Pelleplutt/arduino-watercontrol/README.md

arduino-watercontrol
====================

An Arduino based humidity sensor and water control system
