Pelleplutt/arduino-watercontrol/schematics/display_buttons.sch

## EAGLE design schematics/display_buttons.sch (2013-06-27)

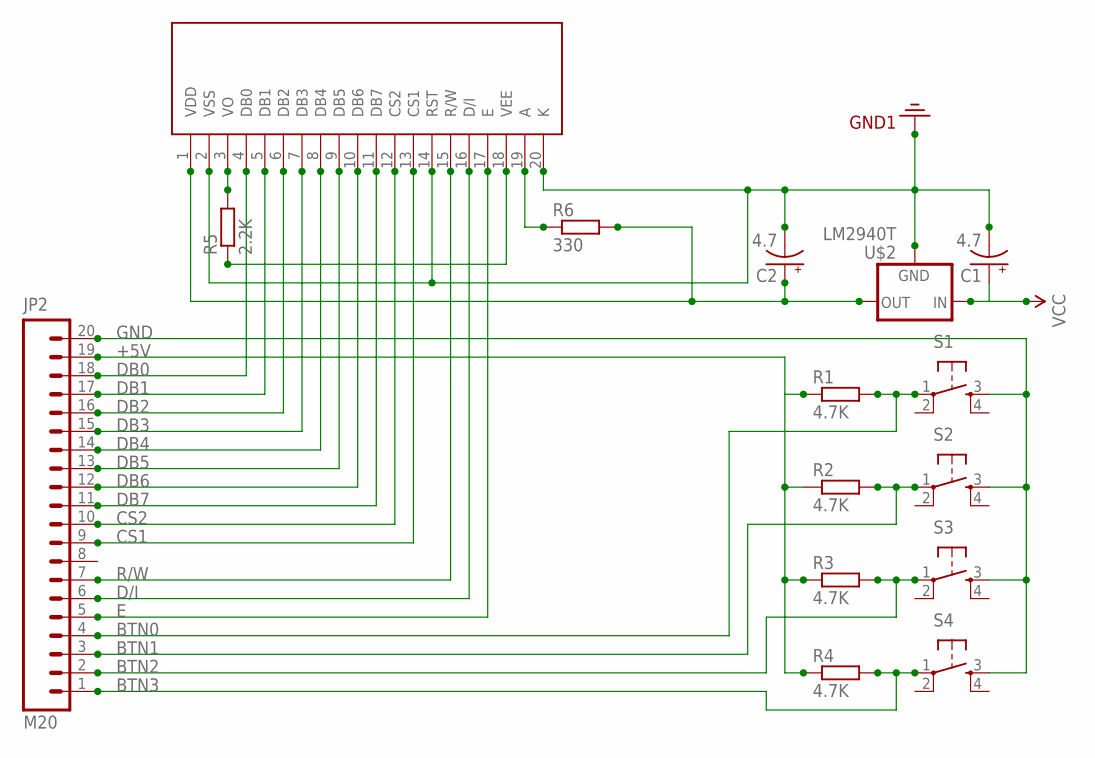
[picture p2: schematic display_buttons.sch]

Parts:
C1, C2: 4.7; CPOL-RADIAL-10UF-25V
JP2: M20; 1X20
R1, R2, R3, R4: 4.7K; 0204/7
R5: 2.2K; 0204/7
R6: 330; 0204/7
S1, S2, S3, S4: TAC_SWITCHPTH; TACTILE-PTH
U$1: LCD-G12864FULL; LCD-G12864
U$2: LM2940T; 78XXL

Connections:
3.3V: C1.2 (-), C2.2 (-), U$1.2 (VSS), U$1.14 (RST), U$1.20 (K), U$2.IN (GND)
+5V: JP2.19, R1.1, R2.1, R3.1, R4.1
BTN0: JP2.4, R1.2, S1.1
BTN1: JP2.3, R2.2, S2.1
BTN2: JP2.2, R3.2, S3.1
BTN3: JP2.1, R4.2, S4.1
CS1: JP2.9, U$1.13 (CS1)
CS2: JP2.10, U$1.12 (CS2)
D/I: JP2.6, U$1.16 (D/I)
DB0: JP2.18, U$1.4 (DB0)
DB1: JP2.17, U$1.5 (DB1)
DB2: JP2.16, U$1.6 (DB2)
DB3: JP2.15, U$1.7 (DB3)
DB4: JP2.14, U$1.8 (DB4)
DB5: JP2.13, U$1.9 (DB5)
DB6: JP2.12, U$1.10 (DB6)
DB7: JP2.11, U$1.11 (DB7)
E: JP2.5, U$1.17 (E)
GND: JP2.20, S1.3, S2.3, S3.3, S4.3
unnamed: C2.1 (+), R6.2, U$1.1 (VDD), U$2.GND (OUT)
unnamed: R5.2, U$1.3 (VO)
unnamed: R5.1, U$1.18 (VEE)
unnamed: R6.1, U$1.19 (A)
R/W: JP2.7, U$1.15 (R/W)
VCC: C1.1 (+), U$2.OUT (IN)
