Pelleplutt/arduino-watercontrol/schematics/moisture_sensors.sch

## EAGLE design schematics/moisture_sensors.sch (2013-06-22)

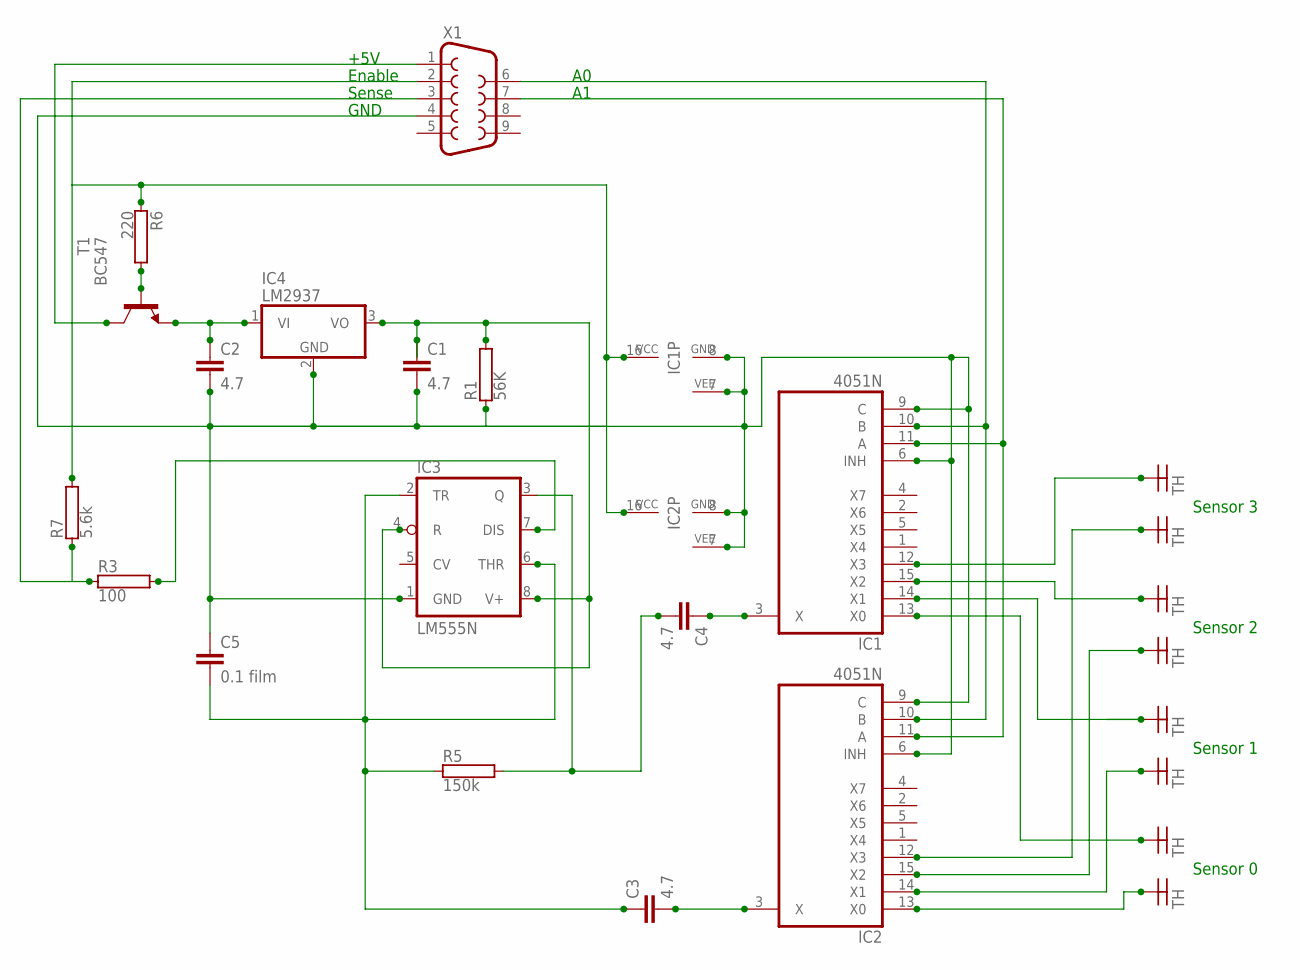
[picture p3: schematic moisture_sensors.sch]

Parts:
C1, C2, C3, C4: 4.7; C2.5-3
C5: 0.1 film; C2.5-3
IC1, IC2: 4051N; DIL16
IC3: LM555N; DIL08
IC4: LM2937; TO263-3
R1: 56K; AC01
R3: 100; AC01
R5: 150k; AC01
R6: 220; AC01
R7: 5.6k; AC01
T1: BC547; TO92
X1: DB9MALE; DB9_MALE

Connections:
unnamed: IC3.7 (DIS), R3.2
unnamed: C2.1, IC4.1 (VI), T1.1 (E)
unnamed: C1.1, IC3.4 (R), IC3.8 (V+), IC4.3 (VO), R1.2
unnamed: R6.2, T1.2 (B)
unnamed: IC1.10 (B), IC2.10 (B), X1.6
unnamed: C3.1, C5.2, IC3.2 (TR), IC3.6 (THR), R5.1
unnamed: IC1.11 (A), IC2.11 (A), X1.7
unnamed: C4.2, IC3.3 (Q), R5.2
unnamed: C4.1, IC1.3 (X)
unnamed: T1.3 (C), X1.1
unnamed: C3.2, IC2.3 (X)
unnamed: C1.2, C2.2, C5.1, IC1.6 (INH), IC1.7 (VEE), IC1.8 (GND), IC1.9 (C), IC1.16 (VCC), IC2.6 (INH), IC2.7 (VEE), IC2.8 (GND), IC2.9 (C), IC2.16 (VCC), IC3.1 (GND), IC4.2 (GND), R1.1, R6.1, R7.2, X1.2, X1.4
unnamed: R3.1, R7.1, X1.3
TH: IC1.12 (X3), IC1.13 (X0), IC1.14 (X1), IC1.15 (X2), IC2.12 (X3), IC2.13 (X0), IC2.14 (X1), IC2.15 (X2)

Notes on the sheet:
Sensor 2
Sensor 3
Sensor 1
Sensor 0
Sense
GND
+5V
Enable
