Pelleplutt/arduino-watercontrol/schematics/relay_board.sch

## EAGLE design schematics/relay_board.sch (2013-06-22)

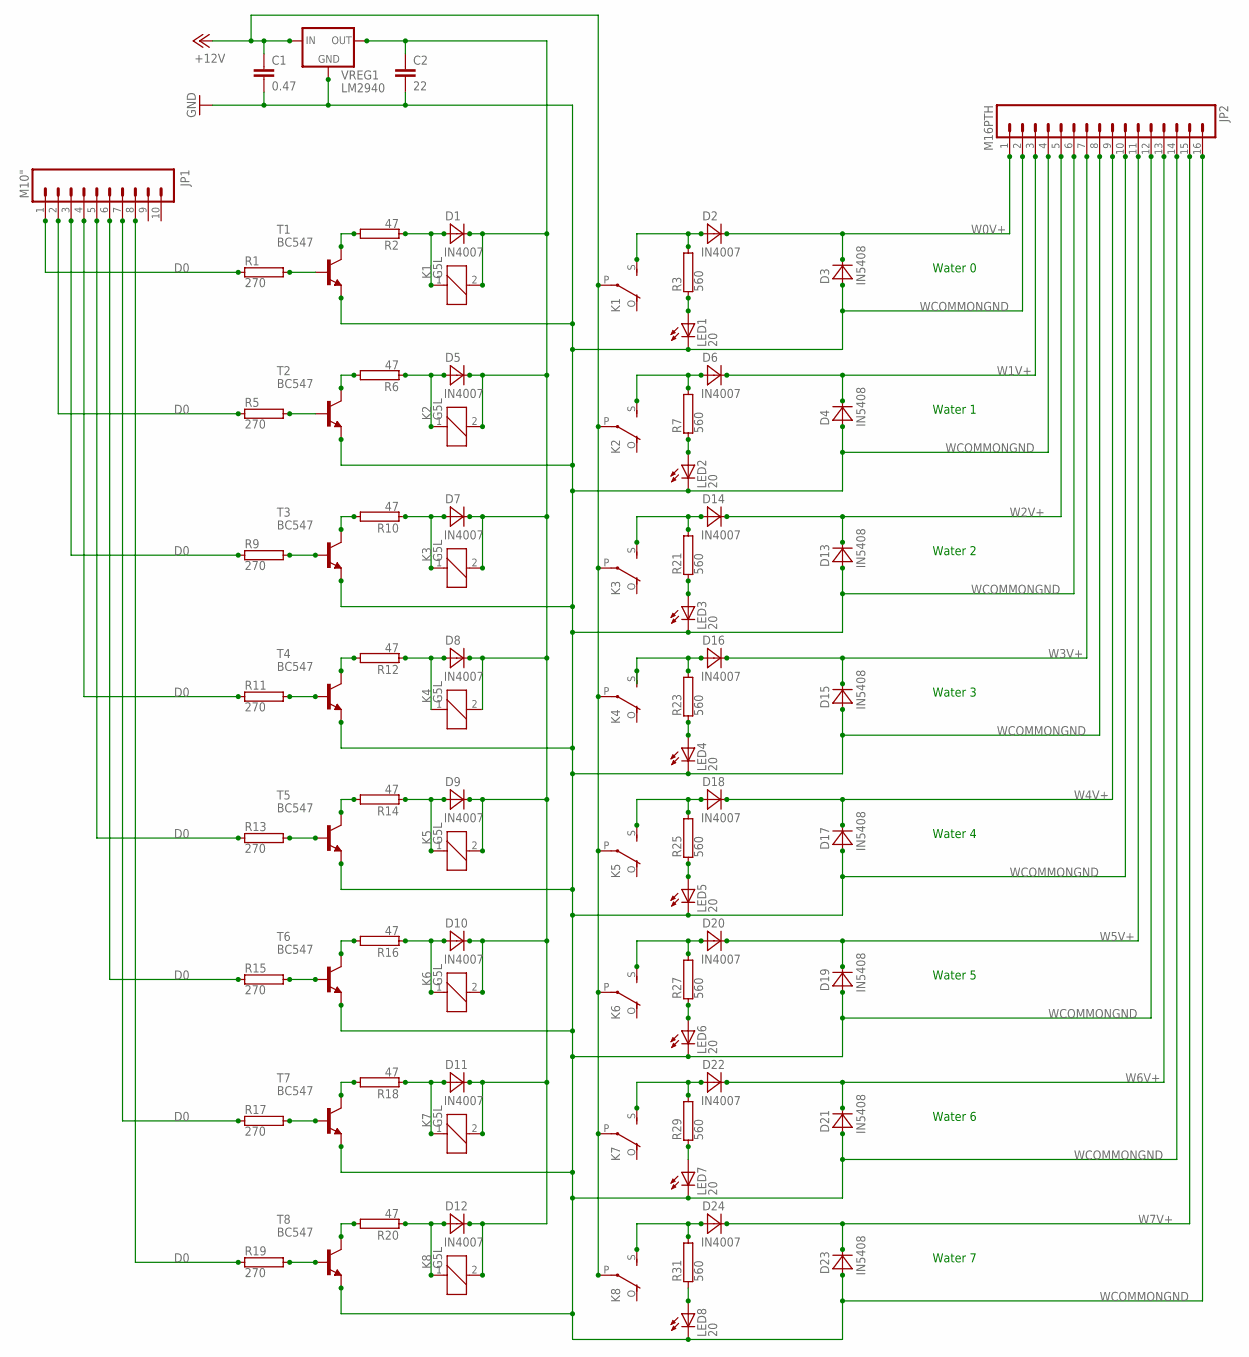
[picture p4: schematic relay_board.sch]

Parts:
C1: 0.47; C2.5-3
C2: 22; C2.5-3
D1, D2, D5, D6, D7, D8, D9, D10, D11, D12, D14, D16, D18, D20, D22, D24: IN4007; DO41-10
D3, D4, D13, D15, D17, D19, D21, D23: IN5408; DO41-10
JP1: M10"; 1X10
JP2: M16PTH; 1X16
K1, K2, K3, K4, K5, K6, K7, K8: G5L; G5LE
LED1, LED2, LED3, LED4, LED5, LED6, LED7, LED8: 20; LED5MM
R1, R5, R9, R11, R13, R15, R17, R19: 270; AC01
R2, R6, R10, R12, R14, R16, R18, R20: 47; AC01
R3, R7, R21, R23, R25, R27, R29, R31: 560; AC01
T1, T2, T3, T4, T5, T6, T7, T8: BC547; TO92
VREG1: LM2940; 78XXL

Connections:
+5VREG: C2.1, D1.C, D5.C, D7.C, D8.C, D9.C, D10.C, D11.C, D12.C, K1.2, K2.2, K3.2, K4.2, K5.2, K6.2, K7.2, K8.2, VREG1.OUT
+12V: C1.1, K1.P, K2.P, K3.P, K4.P, K5.P, K6.P, K7.P, K8.P, VREG1.IN
D0: JP1.1, JP1.2, JP1.3, JP1.4, JP1.5, JP1.6, JP1.7, JP1.8, R1.1, R5.1, R9.1, R11.1, R13.1, R15.1, R17.1, R19.1
unnamed: R1.2, T1.2 (B)
unnamed: R2.2, T1.3 (C)
unnamed: D1.A, K1.1, R2.1
unnamed: R9.2, T3.2 (B)
unnamed: D2.A, K1.S, R3.2
unnamed: LED1.A, R3.1
unnamed: R10.2, T3.3 (C)
unnamed: R5.2, T2.2 (B)
unnamed: R6.2, T2.3 (C)
unnamed: D5.A, K2.1, R6.1
unnamed: D6.A, K2.S, R7.2
unnamed: LED2.A, R7.1
unnamed: D7.A, K3.1, R10.1
unnamed: R11.2, T4.2 (B)
unnamed: R12.2, T4.3 (C)
unnamed: D8.A, K4.1, R12.1
unnamed: R13.2, T5.2 (B)
unnamed: R14.2, T5.3 (C)
unnamed: D9.A, K5.1, R14.1
unnamed: R15.2, T6.2 (B)
unnamed: R16.2, T6.3 (C)
unnamed: D10.A, K6.1, R16.1
unnamed: R17.2, T7.2 (B)
unnamed: R18.2, T7.3 (C)
unnamed: D11.A, K7.1, R18.1
unnamed: R19.2, T8.2 (B)
unnamed: R20.2, T8.3 (C)
unnamed: D12.A, K8.1, R20.1
unnamed: D14.A, K3.S, R21.2
unnamed: LED3.A, R21.1
unnamed: D16.A, K4.S, R23.2
unnamed: LED4.A, R23.1
unnamed: D18.A, K5.S, R25.2
unnamed: LED5.A, R25.1
unnamed: D20.A, K6.S, R27.2
unnamed: LED6.A, R27.1
unnamed: D22.A, K7.S, R29.2
unnamed: LED7.A, R29.1
unnamed: D24.A, K8.S, R31.2
unnamed: LED8.A, R31.1
W0V+: D2.C, D3.C, JP2.1
W1V+: D4.C, D6.C, JP2.3
W2V+: D13.C, D14.C, JP2.5
W3V+: D15.C, D16.C, JP2.7
W4V+: D17.C, D18.C, JP2.9
W5V+: D19.C, D20.C, JP2.11
W6V+: D21.C, D22.C, JP2.13
W7V+: D23.C, D24.C, JP2.15
WCOMMONGND: C1.2, C2.2, D3.A, D4.A, D13.A, D15.A, D17.A, D19.A, D21.A, D23.A, JP2.2, JP2.4, JP2.6, JP2.8, JP2.10, JP2.12, JP2.14, JP2.16, LED1.K (C), LED2.K (C), LED3.K (C), LED4.K (C), LED5.K (C), LED6.K (C), LED7.K (C), LED8.K (C), T1.1 (E), T2.1 (E), T3.1 (E), T4.1 (E), T5.1 (E), T6.1 (E), T7.1 (E), T8.1 (E), VREG1.GND

Notes on the sheet:
Water 0
Water 1
Water 2
Water 3
Water 4
Water 5
Water 6
Water 7
