Pelleplutt/arduino-watercontrol/(commit log)

2013-06-22 Initial commit of Schematics
    [db9.sch, display_buttons.sch, moisture_sensors.sch, relay_board.sch]
2013-06-23 Rename to get away from silly naming limitations in arduino software
2013-06-23 GLCD Control of display connected to the device
2013-06-27 Remove RST from Arduino control, we do not need it connect it to GND.
    [display_buttons.sch]
2013-06-27 Use GLCD standard filenames instead, silly compilers to cause problems
    [arduino.ino, greenhouse.h]
2013-06-27 Sorry, this had to be done. Go Away 2 char indent from the arduino ui, i hate you.
2013-06-27 Better default names for sensors, we have two sensor islands. Name accordingly
2013-06-27 Add defines for button numers, this at least gives us a chance for grep for usage, even if it is a 1-1 map against numbers right now
2013-06-27 Make button handling a bit more logical by using all 4 buttons;
    Use an active_config variable instead of using a negative selection, a
    single byte saved does not justify this sillyness.
2013-06-27 Fix the timestring routinte, this was madness
    [arduino.ino]
2013-06-27 Overhaul the watering configuration option. Set a better name and update button handling
2013-06-29 Update button handleing for manual and enabled
2013-06-30 Add interrupt information for the sensors, swap pin for the connection to match reality
    [ports.h]
2013-06-30 Ok, the CS wiring was correct, stupid cache in the arduino toolkit or something getting the build inconsistent
    [ks0108_watercontrol.h]
2013-06-30 Fix the sensor bar fonts now that we use larger fonts in config
    [arduino.ino]
2013-06-30 Move sensor bar down a bit, we can use the top for other things
2013-06-30 Set initial sensor value to invalid so we can act correct
    [arduino.ino]
2013-06-30 Cache the current time from main to ease calculations later, this way we only need to handle wrapping of millis() for open ports in main
2013-06-30 Change how we handle open ports. Set an open time and a duration. We need this handle wrapping the millis() when we have an open port. It is also cleaner this way
2013-06-30 Main loop handler for opening or closing ports based upon interval timer.
2013-07-03 Calibration routines.
2013-07-03 Adjust ports and interrupts for sensors based upon reality
2013-07-03 Set both max and min (not only min) and abort sensoring when done.
2013-07-03 Long overdue syntax fixes; remove trailing whitespace; Break down function names to the first char of the row in headers
    [arduino.ino, glcd_Config.h, greenhouse.h, gui_config1.ino, gui_log.ino, gui_overview.ino]
2013-07-03 Rearrange code a bit. Split out code from arduino main file and put them into somewhat more logical containers.
2013-07-03 Save and read back values from eeprom for the sensors; Save values when we alter something in config and read back upon boot; Default to somewhat sane values if the entry does not seem valid.
2013-07-03 Print out if the sensor is disabled
2013-07-03 Automatic sensor readings every now and then. Announce blocking actions on display and actions on port
2013-07-05 Display the reading after having read the sensor
2013-07-05 First step in making the config screen behave better; Always clear the screen when we are in edit mode so we know. It is very hard otherwise to know when the buttons have worked or not.
2013-07-05 Only process sensors etc when t > 0s, we use 0 as a signal it has not been done. Display and hide the monitor action label properly.
2013-07-05 Remake how to interpret the interval and trigger values. Make the sensor open if "value is lower then trigger OR at least every interval minutes". This way we still can have a failsafe if the sensor 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
    [arduino.ino, gui_overview.ino]
2013-07-05 Display the time until next open under the current perctage reading in the overview screen upper right.
2013-07-06 Add an additional log of the sensor readings so we can see them over time. Do this on a separate screen shown if we have a trigger value specified (otherwise we will not measure). Rename all current 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
2013-07-06 Use water rather then air for calibration
2013-07-06 Clear log with button 2 in log screens
2013-07-06 Dont print time until next unless we actually have an interval
2013-07-06 Attempt a naive defence against sensors giving bad reads. Ignore any value the differs downwards more then 25%.
2013-07-07 Add a system log of events happening. Ït is quite cumbersome to get an overview of what has happened just looking at the screen of the device. So we will build a global system log of events that we c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
2013-07-07 Test fixes for the gui log screen. Switch to overview after system log. Use a row number as track-keeper and iterate that backwards then displaying or we will show empty or wrong lines. Do not use ti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
    [greenhouse.h, gui_log.ino, log.ino]
2013-07-07 Another attempt of making this right. Seems to work this time. Use the pager as an offset to the current entry instead of attempting to start at an even boundary somehow. Everything else just ends up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
2013-07-07 Cleanup whitespace and switch statements
2013-07-08 Do not open port to often based upon sensor input. We will need to leave some headway here to allow moist to reach the sensor. Keeping this at 15min for now will allow the sensor to rest for at least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
2013-07-08 Schematics of Arduino pinouts used.
    [arduino_pins.sch]
2013-07-08 We disconnected the reset pin, add a comment about it
